hcilab-org/QuadcopterProjectedNavigationCues/README.md

# Quadcopter-Projected In-Situ Navigation Cues for Improved Location Awareness

This repository contains all information to replicate our prototype of a quadcopter mounted projector to display navigation cues for pedestrians. 

## Abstract 
Every day people rely on navigation systems when exploring unknown urban areas. Many navigation systems use multi- modal feedback like visual, auditory or tactile cues. Although other systems exist, users mostly rely on a visual navigation using their smartphone. However, a problem with visual navigation systems is that the users have to shift their attention to the navigation system and then map the instructions to the real world. We suggest using in-situ navigation instructions that are presented directly in the environment by augmenting the reality using a projector-quadcopter. Through a user study with 16 participants, we show that using in-situ instructions for navigation leads to a significantly higher ability to observe real-world points of interest. Further, the participants enjoyed following the projected navigation cues.

## Required Hardware
* DJI Phantom 2
* Phillips PicoPix PPX3610 EU
* lightweight servo motor
* Arduino Yun
* 3mm plywood laser cut base
* 6,0 x 4,5 cm mirror

## Assembly instructions 
A detailed description can be found in [assembly instructions PDF](https://github.com/hcilab-org/QuadcopterProjectedNavigationCues/blob/master/assembly_instructions.pdf).  

## Software 
Deploy the Arduino project to the Arduino Yun and connect to the smartphone running the Android App. 

## Why citing this work

If you are using our work in your research-related documents, it is recommended that you cite the following paper. This way, other researchers can better understand your proposed-work. Your method is more reproducible and thus gaining better credibility.

## How to cite this work

Below is the BibTex entry for citing 'Quadcopter-Projected In-Situ Navigation Cues for Improved Location Awareness'. This work was published at CHI'18.

<pre>
@inproceedings{Knierim:2016,
  author = {Pascal Knierim, Steffen Maurer, Katrin Wolf, Markus Funk},
  title = {Quadcopter-Projected In-Situ Navigation Cues for Improved Location Awareness},
  series = {CHI 2018},
  year = {2018},
  location = {Montreal, QC, Canada},
  url = {https://doi.org/10.1145/3173574.3174007},
  doi = {10.1145/3173574.3174007},
  publisher = {ACM},
  address = {New York, NY, USA},
}
</pre>
